fumikrobot/source-code/README.md

# Fumik robot

In August 2021, I got an idea to make a robot be able to draw pictures on a wall. After many days researching, designing, and programming, I finally finished a robot that could draw any pattern on a wall.
<p align="center">
  
</p>

<br/><br/><br/>

My key-point in design is using general parts to make robot, so end-users can easily renew parts if repairing is needed. Body frame, motor, bolts and nuts, … are all easily found on the market. Main controller is well-known PCB Arduino Mega compatible with CNC Shield to control two stepper motors that allow robot can traverse by belt.
<p align="center">
  
</p>

<br/><br/><br/>
Fumik is now ready for you to hang it on your house wall and start drawing any pictures. You can use Fumik to customize your house with decor picture when you wish; make your house to be special in case of a Christmas, birthday or an anniversary!

<p align="center">
  
  
</p>

<br/><br/><br/>
Fumik is an open source robot! Anyone who loves to understand the robot from the mechanical frame to firmware will be welcome. You can even re-program the robot with Arduino code to start a new way to draw.
<br/>
Arduino code for robot is at https://github.com/fumikrobot/source-code/blob/main/fumik_rv9.ino
<p align="center">
  
</p>

<u><b> How to start a picture: </b></u>
<br/>
3.1 Your Picture need to draw

3.2 Convert picture to vector (*.svg file) by CorelDraw (or any other software support *.svg file)
<br/>
(see sample file test.cdr -> test.svg at https://github.com/fumikrobot/source-code/tree/main/draw%20file%20prepare)

3.3 Convert vector file to code for Arduino (by MS Excel, download at https://github.com/fumikrobot/source-code/blob/main/draw%20file%20prepare/SVG%20code%20extract.xlsm)

3.4 Copy code file to SD card
(sample file draw.txt at https://github.com/fumikrobot/source-code/blob/main/draw%20file%20prepare/draw.txt)

3.5 Plug in SD card to robot and start drawing
<br/><br/><br/><br/>
The robot can help us to make drawing on wall for fun or decoration. You can use robot as gift or STEM KIT for education for your kid, or student, hobbies need to understand about wall drawing robot.
<br/><br/>
The robot is easy to assemble, set-up for drawing. Let's support robot at Crowfunding at https://igg.me/at/fumik-robot
<br/>
Visit robot at https://www.fumik.com/ 
<br/>
<br/>
Watch video during Fumik working:
<br/>
IMAGE ALT TEXT (https://www.youtube.com/watch?v=y8SzFk0X2KM "Fumik - wall drawing robot")
<br/>
I wish to here your response about robot. Thank you.
