fumikrobot/source-code/2. How to make drawing.pdf

Author: Nguyen Huu Phuc
Email: baank83@gmail.com
Date: 2022/May
Step 1 Assembly the pen
Put the pen to pen driver, tight it by rubber band

### 1. HOW TO MAKE DRAWING

WALL DRAWING ROBOT (FUMIK ROBOT)

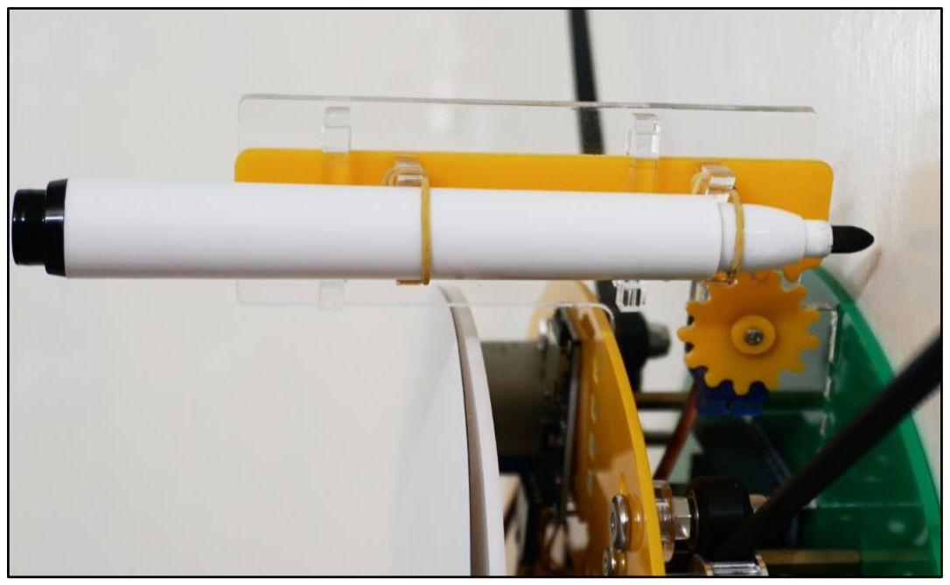
[picture p14: figure]

Step 2 Hang robot on 2 nails pinned on wall Measure distance 2 nails (horizontal direction): p Measure distance 2 nails (vertical direction): w2y (Note: if pin_c is higher pin_a, w2y will be minus value) Measure coordinate of pen: X0, Y0

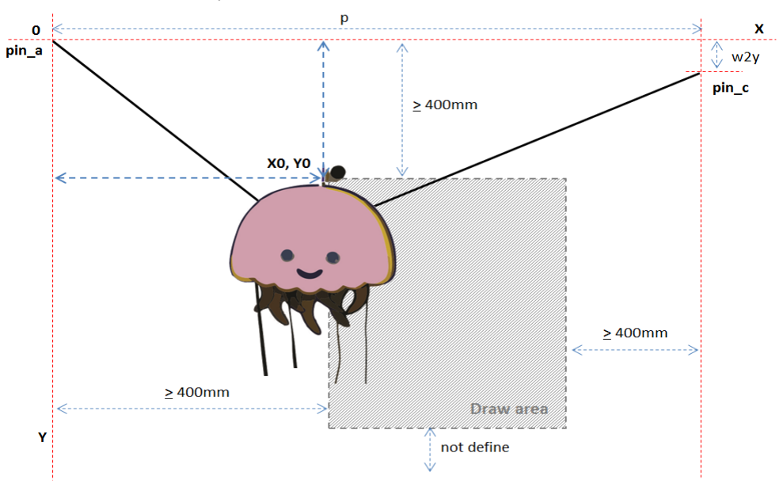
[picture p15: figure]

Put those value to Arduino code

Note: Draw area should keep distance with pin_a, pin_c as above picture (> 400mm)

Step 3 Calibration
Turn off power of robot
Pull slowly forward/ backward the belt (left/ right) to adjust pen to X0, Y0 location
Copy file calib to sd card, re-name it to "Draw.txt" -> put sd card to robot and power it to start drawing calib line

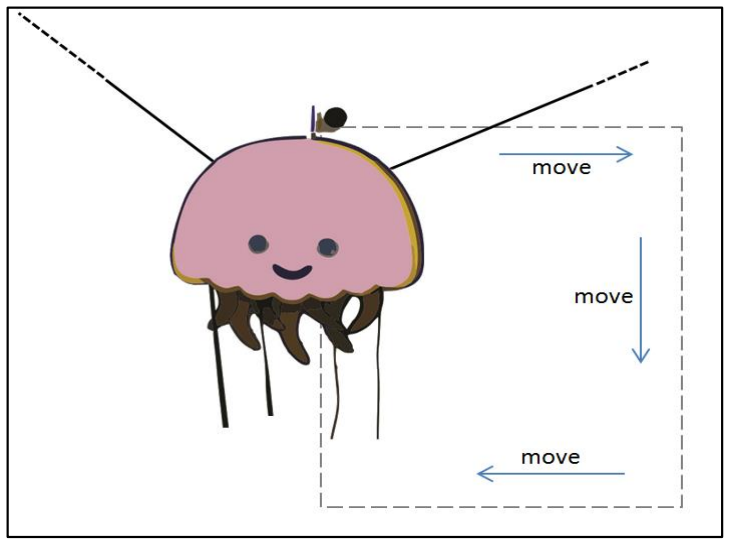
[picture p16: figure]

Robot will draw a rectangle (dot line)
(after finished drawing, robot will return to home position X0, Y0)

Check if the rectangle has exact dimension (width, height) If not exact, return step 2, check if parameter p, w2y, x0, y0 is exact
If need, adjust x_ratio, y_ratio to make drawed rectangle get exact dimension

Check if the rectangle is tilt or not If need, adjust x_angle, y_angle to make drawed rectangle to be aligned

When the drawed rectangle is acceptable, then robot is ready for other drawings

Step 4 Your Picture need to draw

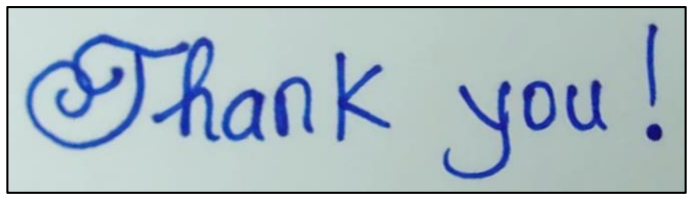
[picture p17: figure]

Step 5 Convert picture to vector (*.svg file) by CorelDraw (or any other software support *.svg file)

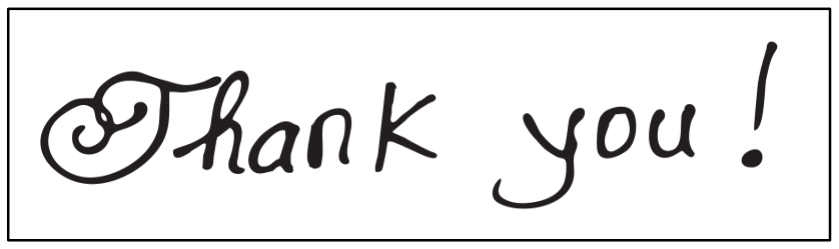
[picture p18: figure]

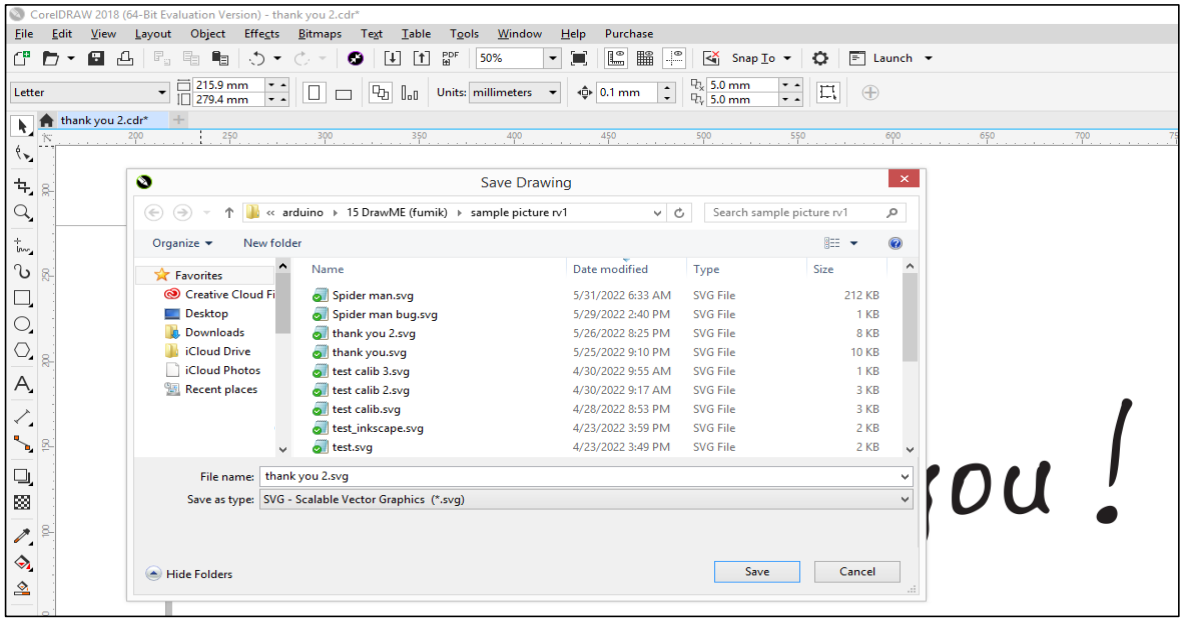
[picture p19: figure]

Step 6 | Convert vector file to code for Arduino (by MS Excel) | download here
| Copy information of line/ curve in *.svg file

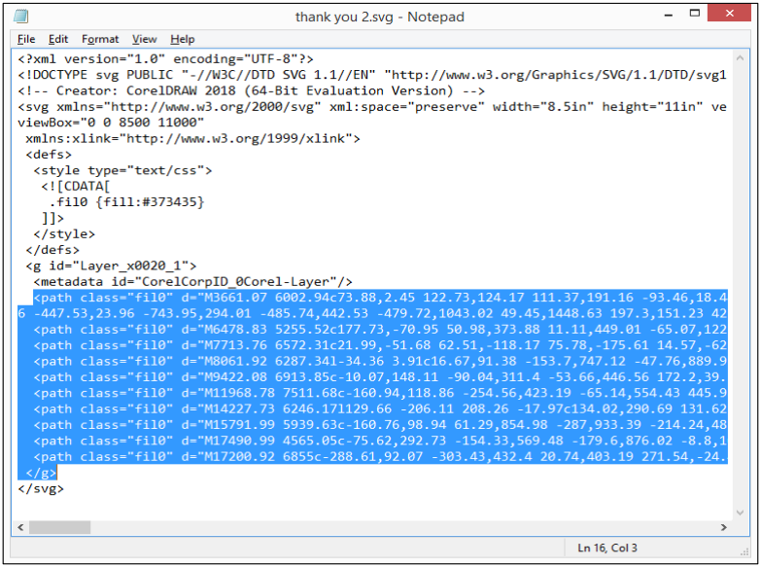
[picture p20: figure]

Paste those curve/ line information into converter file "SVG code converter"

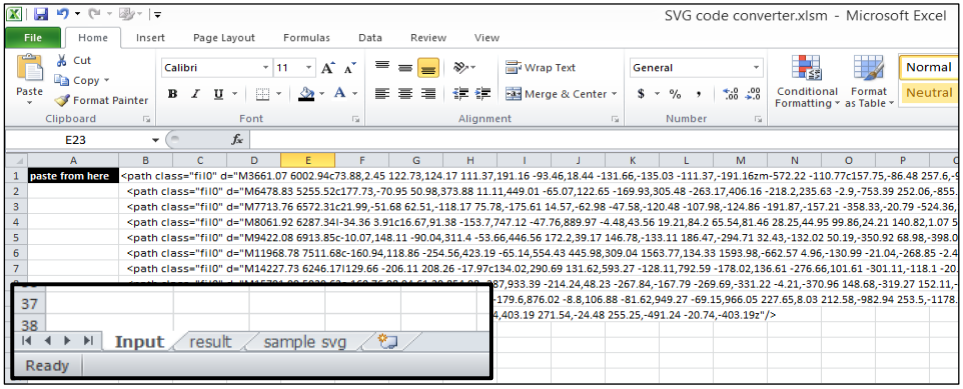
[picture p21: figure]

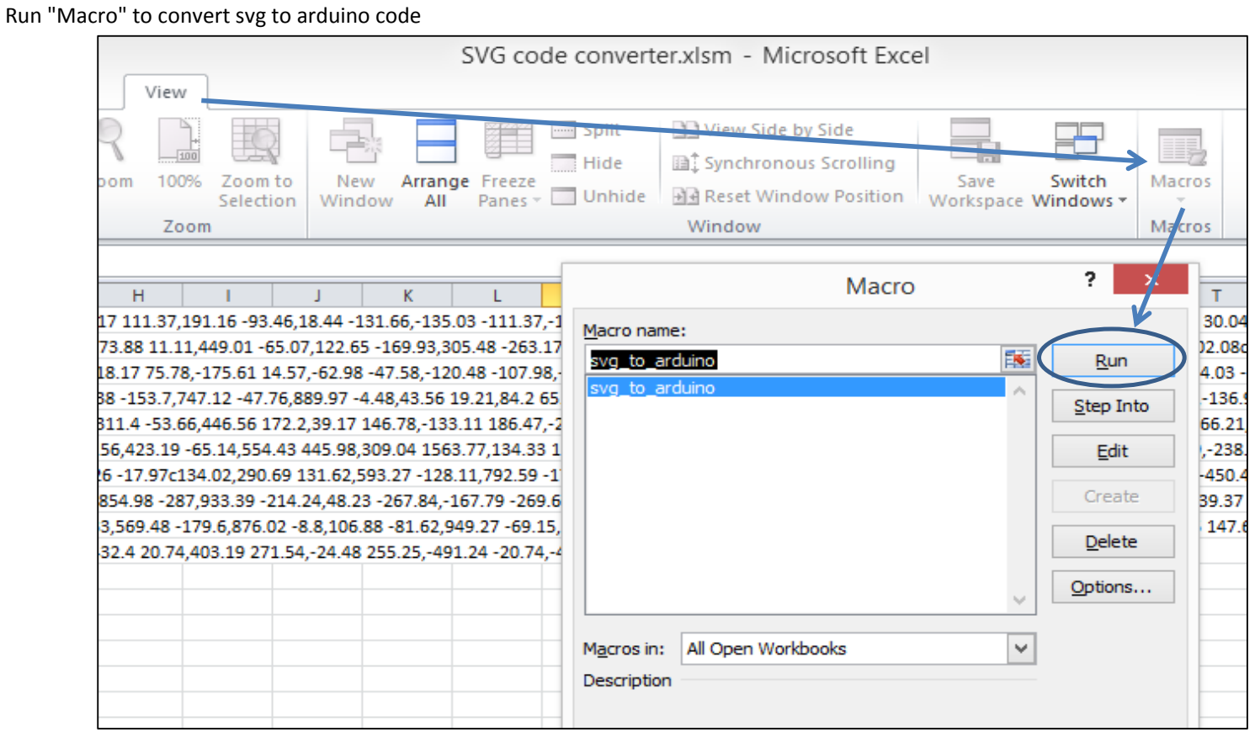
[picture p22: figure]

Run "Macro" to convert svg to arduino code

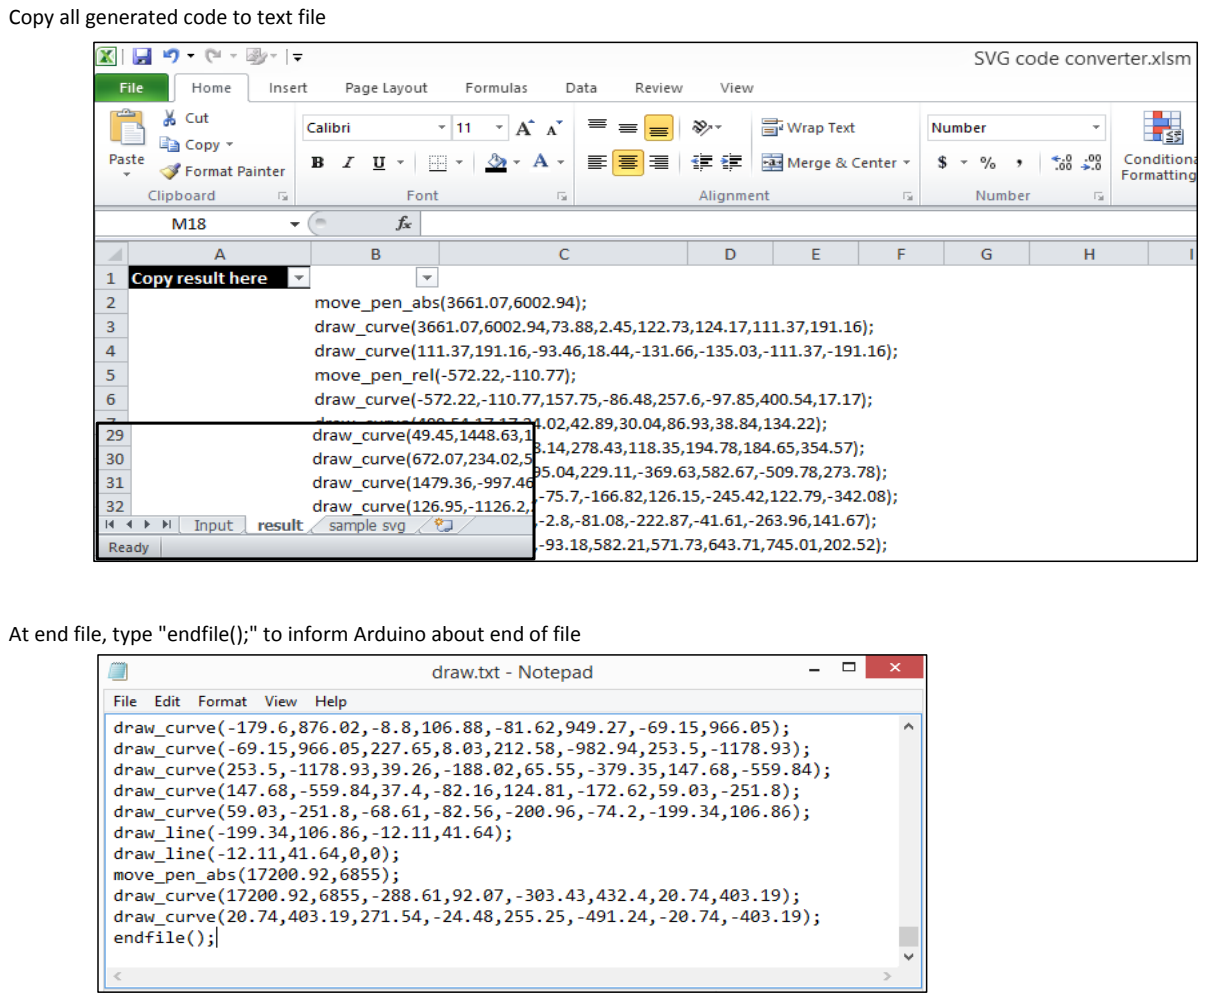
[picture p23: page 9]

Copy all generated code to text file

At end file, type "endfile();" to inform Arduino about end of file

Step 7 Copy code file "draw.txt" to SD card
Step 8 Plug in SD card to robot and start drawing

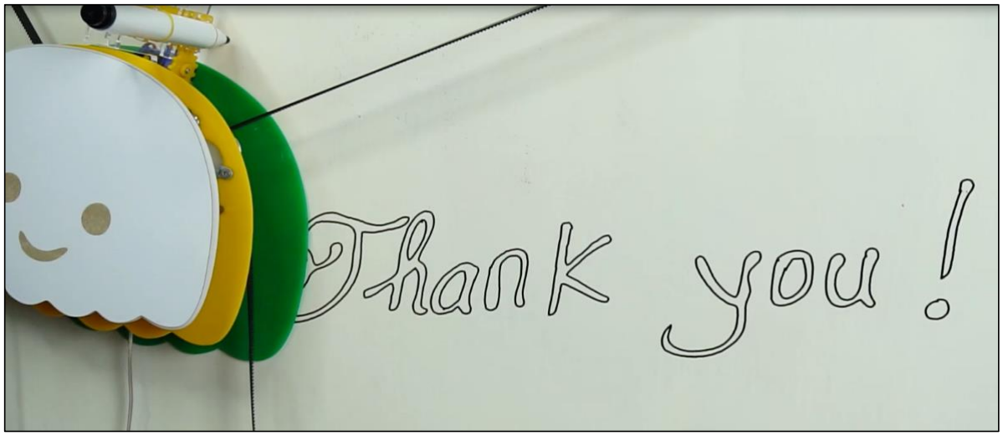
[picture p24: figure]
