fumikrobot/source-code/draw file examples/Draw star test.txt

move_pen_abs(24763.94,5150.02);
draw_curve(24763.94,5150.02,-78.61,-140.02,-352.69,-133.63,-487.83,-136.33);
draw_curve(-487.83,-136.33,-276.02,-5.57,-553.02,19.79,-828.09,42.13);
draw_curve(-828.09,42.13,-147.6,-343.61,-163.89,-891.24,-555.91,-1088.41);
draw_curve(-555.91,-1088.41,-134.17,-67.65,-241.46,42.38,-305.7,145.47);
draw_curve(-305.7,145.47,-77.76,128.69,-126.65,279,-178.41,419.02);
draw_curve(-178.41,419.02,-59.25,163.22,-132.22,315.51,-136.09,490.15);
draw_curve(-136.09,490.15,-302.87,7.55,-603.68,15.96,-906.61,20.67);
draw_curve(-906.61,20.67,-102.51,1.89,-392.11,-22.44,-389.13,146.51);
draw_curve(-389.13,146.51,2.83,173.93,197.44,323.27,316.33,429.31);
draw_curve(316.33,429.31,230.93,207.7,427.49,428.16,637.26,657.35);
draw_curve(637.26,657.35,4.81,4.81,9.65,8.5,15.31,11.33);
draw_curve(15.31,11.33,-60.37,156.92,-86.22,324,-135.09,484.7);
draw_curve(-135.09,484.7,-47.89,161.52,-111.19,323.15,-133.17,490.33);
draw_curve(-133.17,490.33,-16.35,124,25.76,304.39,199.36,254.37);
draw_curve(199.36,254.37,388.12,-110.67,781.15,-412.21,1087.8,-676.23);
draw_curve(1087.8,-676.23,217.69,170.04,414.03,362.52,637.35,526.13);
draw_curve(637.35,526.13,120.93,89.27,400.73,237.57,553.14,127.66);
draw_curve(553.14,127.66,380.42,-274.19,-291.39,-880.04,-357.58,-1194.78);
draw_curve(-357.58,-1194.78,220.52,-269.48,457.2,-463.93,731.34,-679.06);
draw_curve(731.34,-679.06,135,-106.04,340.26,-286.34,235.74,-470.33);
move_pen_rel(-526.17,561.36);
draw_line(-526.17,561.36,0,0);
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
draw_curve(0,0,-203.2,13.21,-346.08,-251.76,-309.6,-418.93);
draw_curve(-309.6,-418.93,37.33,-171.9,204.14,-228.22,357.49,-217.84);
draw_curve(357.49,-217.84,5.81,0,10.57,0,16.26,-1.89);
draw_curve(16.26,-1.89,366.23,4.69,274.19,617.04,-64.15,638.66);
endfile();
star only for test
