fumikrobot/source-code/draw file examples/Draw test frame.txt

move_pen_abs(27958.5,5852.97);
draw_curve(27958.5,5852.97,232.73,-516.53,1452.96,-1084.32,2081.93,-1033.62);
draw_curve(2081.93,-1033.62,-658.66,330.83,-1218.45,617.6,-1646.13,1196.5);
draw_line(-1646.13,1196.5,-435.8,-162.87);
draw_line(-435.8,-162.87,0,0);
move_pen_abs(29872.35,6045.59);
draw_line(29872.35,6045.59,-590.38,516.41);
draw_line(-590.38,516.41,-796.41,-466.71);
draw_curve(-796.41,-466.71,323.14,-562.7,1286.08,-1136.49,1957.15,-1285.65);
draw_curve(1957.15,-1285.65,538.67,31.79,738.26,241.8,946.02,714.99);
draw_curve(946.02,714.99,-545.11,90.85,-1208.73,476.13,-1516.38,520.97);
move_pen_abs(27507.49,7782.56);
draw_curve(27507.49,7782.56,-447.72,-225.19,57.93,-1487.96,337.18,-1836.33);
draw_line(337.18,-1836.33,457.71,120.45);
draw_curve(457.71,120.45,-105.17,268.38,-334.83,530.94,-467.11,834.11);
draw_curve(-467.11,834.11,-111.88,256.43,-210.8,680.87,-327.78,881.77);
move_pen_abs(27618.66,7909.04);
draw_curve(27618.66,7909.04,70.76,-501.24,435.48,-1431.74,825.65,-1762.42);
draw_line(825.65,-1762.42,719.42,481.82);
draw_curve(719.42,481.82,-161.43,489.13,-449.81,301.15,-735.69,1730.21);
draw_line(-735.69,1730.21,-809.39,-449.61);
draw_line(-809.39,-449.61,0,0);
move_pen_abs(29391.41,6628.44);
draw_curve(29391.41,6628.44,361.9,-494.3,1429.19,-947.08,2049.19,-1007.05);
draw_curve(2049.19,-1007.05,222.36,271.75,414.25,858.67,530.19,1206.53);
draw_curve(530.19,1206.53,-300.02,111.27,-554.61,163.82,-849.78,312.04);
draw_curve(-849.78,312.04,-235.07,118.05,-464.27,348.78,-679.11,430.6);
draw_line(-679.11,430.6,-1050.48,-942.13);
draw_line(-1050.48,-942.13,0,0);
move_pen_abs(29422.92,8740.94);
draw_line(29422.92,8740.94,-885.78,-322.2);
draw_curve(-885.78,-322.2,49.85,-540.89,309.9,-1369.25,755.47,-1706.73);
draw_line(755.47,-1706.73,272.2,235.32);
draw_line(272.2,235.32,793.66,702.91);
draw_curve(793.66,702.91,-259.33,474.48,-583.13,430.76,-756.48,1150.82);
draw_line(-756.48,1150.82,-179.06,-60.11);
draw_line(-179.06,-60.11,0,0);
endfile();
spider man - frame for test
