fumikrobot/source-code/draw file examples/Draw test red.txt

move_pen_abs(28118.19,5847.52);
draw_line(0,0,571.170000000002,-571.160000000001);
move_pen_abs(28239.78,5892.96);
draw_line(0,0,779.850000000002,-779.84);
move_pen_abs(28361.37,5938.41);
draw_line(28361.37,5938.41,72.83,-72.83);
move_pen_rel(381.79,-381.79);
draw_line(381.79,-381.79,476.02,-476.02);
move_pen_abs(29352.26,5114.55);
draw_line(0,0,176.620000000003,-176.610000000001);
move_pen_abs(29720.5,4913.35);
draw_line(0,0,18.2799999999988,-18.2800000000007);
move_pen_abs(27740.45,6225.27);
draw_line(0,0,192.669999999998,-192.68);
move_pen_abs(27595.07,6537.68);
draw_line(0,0,470.279999999999,-470.29);
move_pen_abs(27499.76,6800.03);
draw_line(0,0,697.830000000002,-697.84);
move_pen_abs(27435.79,7031.02);
draw_line(0,0,589.389999999999,-589.38);
move_pen_abs(27400.1,7233.75);
draw_line(0,0,397.290000000001,-397.3);
move_pen_abs(27391.12,7409.76);
draw_line(0,0,300.530000000002,-300.530000000001);
move_pen_abs(27410.82,7557.09);
draw_line(0,0,200.110000000001,-200.110000000001);
move_pen_abs(27464.56,7670.39);
draw_line(0,0,54.75,-54.7600000000002);
move_pen_abs(29019.08,7118.06);
draw_line(0,0,301.349999999999,-301.34);
move_pen_abs(28844.58,7459.6);
draw_line(0,0,565.429999999997,-565.43);
move_pen_abs(28746.48,7724.73);
draw_line(0,0,753.119999999999,-753.12);
move_pen_abs(28679.68,7958.56);
draw_line(0,0,908.779999999999,-908.780000000001);
move_pen_abs(28633.37,8171.91);
draw_line(0,0,1043.67,-1043.67);
move_pen_abs(28603.71,8368.6);
draw_line(0,0,1161.92,-1161.91);
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
move_pen_abs(30200.92,7272.49);
draw_line(0,0,1353.63,-1353.63);
move_pen_abs(30288.98,7351.46);
draw_line(0,0,1319.92,-1319.92);
move_pen_abs(30377.04,7430.44);
draw_line(0,0,1282.74,-1282.74);
move_pen_abs(30495.28,7479.22);
draw_line(0,0,1212.66,-1212.65);
endfile();
spider man - red for test
