fumikrobot/source-code/(threads)

Thread 3 (2022-03-15):

Documentation and Move the code into it's own sub-folder for Arduino

drf5n, 2022-03-15:
It would be nice to have the code be in it's own fumik_rv9 subfolder like:  fumik_rv9/fumik_rv9.ino so Arduino doesn't complain and move it.

It would also be nice to see a diagram identifying the triangles, angles and constants in https://github.com/fumikrobot/source-code/blob/cf6d6d794c014ce6a81f114d8591082b22c6cf37/fumik_rv9.ino#L315
As is, it looks very difficult to calibrate to a new installation.  Is https://github.com/fumikrobot/source-code/blob/cf6d6d794c014ce6a81f114d8591082b22c6cf37/fumik_rv9.ino#L324 the distance between the anchors?

Cool project, thanks.

Thread 5 (2022-04-18):

Dimensions for the Body & Penholder-Parts

WasMachenSachen, 2022-04-18:
Hi there,
are the Dimensions for the mechanical parts available somewhere?

ArvinthTM, 2024-01-29:
> Hi there, are the Dimensions for the mechanical parts available somewhere?

did you find those?

WasMachenSachen, 2024-01-29:
> > Hi there, are the Dimensions for the mechanical parts available somewhere?
>
> did you find those?

No, I did not.

ArvinthTM, 2024-02-05:
if you have a 3d printer , heres a model that i made in fusion (i tried)

https://drive.google.com/file/d/1ccVnGx4-kzd6ip65Pa2imz5G62c7bQAo/view?usp=sharing

ArvinthTM, 2024-02-05:
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
its currently being developed if you want use this😊(i dont ask money)
